napatGNK/DC-power-monitor/README.md

# IoT DC Power Meter

เครื่องวัดพลังงานไฟฟ้ากระแสตรงพร้อมแดชบอร์ดเรียลไทม์ สร้างด้วย ESP32 และเซนเซอร์ INA219

เป้าหมายคือตอบคำถามว่าอุปกรณ์ไฟ DC ที่เราใช้กันกินไฟจริงเท่าไหร่ มัลติมิเตอร์ทั่วไปบอกได้แค่ค่า ณ ขณะนั้น ไม่บอกพลังงานสะสมและมองไม่เห็นการเปลี่ยนแปลงที่เกิดเร็วกว่าจังหวะที่จอจะอัปเดตทัน เครื่องนี้ทำได้ทั้งสองอย่างและดูผ่านมือถือได้

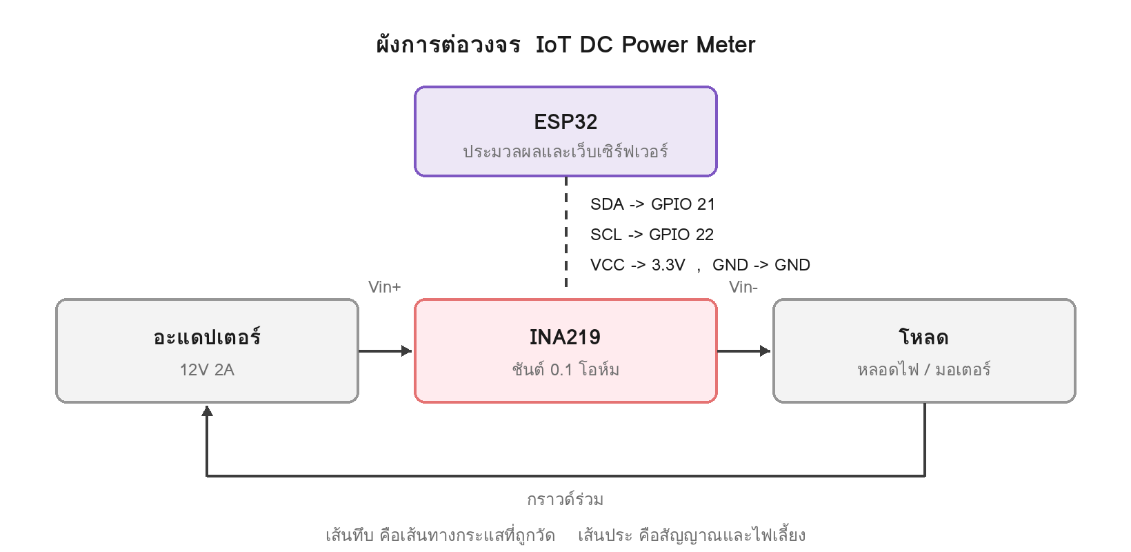
[picture p1: images/wiring_diagram.png]
ผังการต่อวงจร


รายละเอียดการต่อสายทั้งหมดอยู่ใน [wiring.md](wiring.md)

---

## ทำไมต้องสลับย่านการวัดได้

ไลบรารีของ INA219 ตั้งค่าเริ่มต้นไว้ที่ย่าน 32V/2A ซึ่งเป็นค่าที่โปรเจคส่วนใหญ่ใช้ตามกันมาโดยไม่เปลี่ยน

แต่เมื่อวัดโหลดจริงพบว่ามอเตอร์หมุนเปล่ากินราว 120 mA และหลอดไฟราว 220 mA นั่นคือใช้ช่วงการวัดไปเพียงราว 6–11% ของที่เซนเซอร์ทำได้ ความละเอียดที่เหลือจึงหยาบเกินความจำเป็น และสัญญาณรบกวนปรากฏชัดเป็นสัดส่วน

การเปลี่ยนไปใช้ย่าน 16V/400mA ให้ความละเอียดสูงขึ้นราว 5 เท่า แต่แลกมาด้วยเพดานที่ต่ำลง ซึ่งเป็นปัญหาเมื่อต้องวัดกระแสกระชากขณะมอเตอร์เริ่มหมุนที่พุ่งเกิน 600 mA

**จึงออกแบบให้สลับย่านได้สองโหมด** ใช้ย่านละเอียดเมื่อวัดค่าขณะทำงานปกติ และย่านกว้างเมื่อต้องจับค่าสูงสุด สลับได้ทั้งจากปุ่ม BOOT บนบอร์ดและจากหน้าเว็บ

การแลกกันระหว่างความละเอียดกับพิสัยการวัดคือแนวคิดหลักของวิชาการวัด และในโปรเจคนี้มันไม่ได้มาจากตำรา แต่มาจากการวัดโหลดจริงแล้วพบว่าค่าเริ่มต้นไม่เหมาะสม

---

## ข้อสังเกตเรื่องฉลากหลอดไฟ

หลอดที่ใช้ทดสอบระบุบนฉลากว่า 12V 5W

เมื่อวัดจริงที่แรงดัน 12.03 V ซึ่งอยู่ที่ค่าพิกัดพอดี ได้กำลังไฟเพียง 2.691 W

คำนวณย้อนกลับได้ความต้านทานขณะร้อน 12.03 ÷ 0.2237 = 53.8 Ω ขณะที่หลอด 12V 5W ตามทฤษฎีควรมีค่า 12 ÷ 0.417 = 28.8 Ω

ความต้านทานจริงสูงกว่าที่ควรเป็นเกือบสองเท่า เมื่อแรงดันถูกต้องแล้ว ตัวแปรที่เหลือมีเพียงคุณสมบัติของไส้หลอดเอง จึงสรุปได้ว่า **คุณสมบัติจริงของหลอดไม่ตรงกับที่ระบุบนฉลาก**

จึงใช้ค่าที่วัดได้เป็นหลักในการคำนวณทั้งหมด ไม่ใช้ค่าบนฉลาก

---

## อุปกรณ์หลัก

| ส่วน | อุปกรณ์ |
|---|---|
| ประมวลผลและเว็บเซิร์ฟเวอร์ | ESP32 DevKit พร้อมบอร์ดขยาย 30 ขา |
| วัดกระแสและแรงดัน | INA219 ชันต์ 0.1 Ω, I2C address 0x40 |
| แหล่งจ่ายทดสอบ | อะแดปเตอร์ 12V 2A แบบขั้วบวกตรงกลาง |
| โหลดทดสอบ | หลอดไฟ 12V และมอเตอร์เกียร์ ZGA37RG 12V 300 rpm |
| เครื่องมืออ้างอิง | มัลติมิเตอร์ ZENTOR ZT34000 |

---

## การต่อสาย

ฝั่งสัญญาณ

| ขา INA219 | ต่อเข้า ESP32 |
|---|---|
| VCC | 3.3V |
| GND | GND |
| SDA | GPIO 21 |
| SCL | GPIO 22 |

ฝั่งไฟที่ถูกวัด

- ขั้วบวกอะแดปเตอร์ เข้า `Vin+`
- `Vin-` ออกไปยังขั้วบวกของโหลด
- ขั้วลบของโหลด กลับเข้าขั้วลบอะแดปเตอร์

เซนเซอร์ต่อ**อนุกรม**ในเส้นทางไฟ ไม่ใช่ต่อคร่อมแบบโวลต์มิเตอร์

**กราวด์ของ ESP32 ต้องต่อร่วมกับขั้วลบของแหล่งจ่าย** เพราะแรงดันคือผลต่างระหว่างสองจุดเสมอ หากไม่มีจุดอ้างอิงร่วมกัน ค่าที่อ่านได้จะลอยและไม่ซ้ำเดิม

---

## หลักการทำงาน

INA219 มีตัวต้านทานชันต์ 0.1 Ω ต่ออนุกรมอยู่ในเส้นทางไฟ กระแสที่ไหลผ่านทำให้เกิดแรงดันตกคร่อมเล็กน้อย ชิปวัดแรงดันนั้นแล้วใช้กฎของโอห์มคำนวณกลับเป็นกระแส พร้อมกับวัดแรงดันบัสไปด้วย

ESP32 อ่านค่าผ่านบัส I2C ทุก 200 มิลลิวินาที โดยแต่ละรอบอ่าน 20 ครั้งแล้วเฉลี่ยเพื่อลดสัญญาณรบกวน จากนั้นคำนวณ

- กำลังไฟ จากผลคูณของแรงดันกับกระแส
- พลังงานสะสม จากผลรวมของกำลังไฟคูณกับช่วงเวลาที่ผ่านไปในแต่ละรอบ

ค่าพลังงานสะสมนี้เองที่ทำให้อุปกรณ์เป็นมิเตอร์ ไม่ใช่เพียงเครื่องวัดค่าปัจจุบัน

ESP32 เปิดเว็บเซิร์ฟเวอร์ในตัวและส่งค่าออกมาเป็น JSON ให้เบราว์เซอร์ดึงไปวาดกราฟทุกครึ่งวินาที

---

## การออกแบบเพื่อความน่าเชื่อถือ

**โหมดปล่อยสัญญาณไวไฟของตัวเอง** หากเชื่อมต่อเครือข่ายที่ตั้งไว้ไม่สำเร็จภายใน 12 วินาที ระบบจะเปลี่ยนไปปล่อยสัญญาณชื่อ `PowerMeter` เอง ทำให้สาธิตได้ในสถานที่ที่ไม่มีเครือข่ายที่รู้จัก

**แยกแหล่งจ่ายไฟของ ESP32 ออกจากวงจรที่วัด** จ่ายไฟตัวควบคุมผ่าน USB เพื่อไม่ให้กระแสที่ ESP32 ใช้ถูกนับรวมเข้าไปในค่าที่วัด และเพื่อไม่ให้แรงดันตกจากโหลดไปกระทบการทำงาน

**โหมดค่าจำลอง** สลับได้จากค่าคงที่บรรทัดเดียวในโค้ด ใช้พัฒนาและทดสอบหน้าเว็บโดยไม่ต้องต่อฮาร์ดแวร์

**เก็บค่ากระแสสูงสุดไว้ต่างหาก** เพราะปรากฏการณ์ชั่วขณะอย่างกระแสกระชากจะหายไปจากกราฟเมื่อเลื่อนพ้นหน้าจอ

---

## ผลการทดสอบ

### แรงดัน

| ครั้ง | มัลติมิเตอร์ (V) | เครื่องนี้ (V) | คลาดเคลื่อน |
|---|---|---|---|
| 1 | 11.91 | 11.99 | +0.67% |
| 2 | 11.89 | 11.95 | +0.50% |
| 3 | 11.97 | 12.04 | +0.58% |

เฉลี่ย **+0.58%** และเป็นบวกทุกครั้งในช่วงแคบ ซึ่งเป็นลักษณะของความคลาดเคลื่อนเชิงระบบ ไม่ใช่ค่าสุ่ม สาเหตุน่าจะมาจากค่าชันต์จริงไม่ตรง 0.1 Ω พอดี

เนื่องจากมัลติมิเตอร์เองมีความไม่แน่นอนราว ±0.5% จึงสรุปได้เพียงว่าเครื่องมือทั้งสองให้ค่าที่สอดคล้องกัน ไม่สามารถสรุปว่าตัวใดถูกต้องกว่ากัน

### พลังงานสะสม

ทดสอบกับหลอดไฟต่อเนื่อง 126 นาที

| รายการ | ค่า |
|---|---|
| กำลังไฟเฉลี่ย | 2.691 W |
| ระยะเวลา | 2.10 ชั่วโมง |
| คำนวณด้วยมือ | 5.651 Wh |
| เครื่องนับได้ | 5.6001 Wh |
| คลาดเคลื่อน | −0.90% |

ค่าที่ต่ำกว่าเล็กน้อยอธิบายได้ เพราะการคำนวณด้วยมือใช้กำลังไฟ ณ ขณะสุดท้ายมาคูณตลอดช่วง โดยสมมติว่าคงที่ ในความเป็นจริงช่วงแรกที่ไส้หลอดยังไม่ร้อนเต็มที่ กำลังไฟต่ำกว่านั้น ค่าที่เครื่องนับได้จึงน่าเชื่อถือกว่าค่าอ้างอิง

### กระแสกระชากของมอเตอร์

| สภาวะ | กระแส |
|---|---|
| หมุนปกติ | 101–120 mA |
| ขณะสตาร์ท | 285.9 ถึง 616.0 mA |

คิดเป็น 2.4 ถึง 5.1 เท่า เกิดจากในจังหวะแรกมอเตอร์ยังไม่มีแรงเคลื่อนไฟฟ้าต้านกลับ ขดลวดจึงเหลือเพียงความต้านทานล้วน เมื่อความเร็วเพิ่มขึ้น แรงเคลื่อนต้านกลับเพิ่มตาม กระแสจึงลดลงจนเข้าที่

การทดสอบเปิดปิดหลอดไฟซ้ำหลายรอบให้ค่าที่ระดับคงที่เท่ากันทุกครั้ง แสดงว่าการวัดมีความสามารถทำซ้ำได้

---

## ปัญหาที่พบระหว่างสร้าง

**ค่าที่อ่านได้ไม่นิ่ง** — การอ่านค่าเพียงครั้งเดียวต่อรอบทำให้ตัวเลขกระโดดจนอ่านไม่ได้ แก้ด้วยการอ่าน 20 ครั้งแล้วเฉลี่ยก่อนแสดงผล

**ย่านการวัดเริ่มต้นไม่เหมาะกับโหลด** — นำไปสู่การออกแบบระบบสลับย่านตามที่อธิบายไว้ข้างต้น

**โมดูล OLED เสียหาย** — โมดูล OLED เรียงขาเป็น GND/VCC ซึ่งสลับกับ INA219 ที่เป็น VCC/GND ทำให้ต่อไฟกลับขั้วและชิปไดรเวอร์เสียหายถาวร จึงเปลี่ยนไปแสดงผลผ่านเว็บเพียงทางเดียว ซึ่งกลับมีข้อดีคือดูค่าได้จากมือถือโดยไม่ต้องเข้าใกล้วงจรที่มีไฟ

**การเทียบค่าครั้งแรกใช้ย่านมัลติมิเตอร์ผิด** — วัดกระแสในย่าน 10A ซึ่งมีความละเอียดขั้นละ 10 mA ขณะที่ค่าที่วัดอยู่ราว 100 mA ทำให้เปรียบเทียบไม่ได้ ต้องย้ายไปย่าน 200 mA ซึ่งเป็นปัญหาเดียวกับที่เจอในฝั่งเซนเซอร์เอง

---

## ข้อจำกัด

ระบบสุ่มตัวอย่างที่ 5 ครั้งต่อวินาที ขณะที่กระแสกระชากขณะสตาร์ทกินเวลาไม่ถึง 50 มิลลิวินาที ค่าสูงสุดที่บันทึกได้จึงเป็นค่าต่ำสุดที่ยืนยันได้ว่าเกิดขึ้นจริง ไม่ใช่ค่าพีคที่แท้จริง ซึ่งอธิบายว่าทำไมค่าที่วัดได้ในแต่ละครั้งจึงต่างกันมาก

การเฉลี่ย 20 ครั้งต่อรอบยังทำหน้าที่เหมือนตัวกรองความถี่ต่ำ ที่รีดยอดแหลมให้เตี้ยลงโดยธรรมชาติ

หากต้องการวัดกระแสกระชากอย่างแม่นยำ จะต้องเพิ่มอัตราการสุ่ม ลดการเฉลี่ย หรือใช้วงจรจับค่าสูงสุดแบบฮาร์ดแวร์แยกต่างหาก

---

## แนวทางพัฒนาต่อ

- ใช้ INA219 สองตัววัดขาเข้าและขาออกของตัวแปลงไฟ เพื่อคำนวณประสิทธิภาพ
- บันทึกข้อมูลลงการ์ด SD เพื่อดูย้อนหลังระยะยาว
- เพิ่มการแจ้งเตือนเมื่อกระแสเกินค่าที่กำหนด
- ปรับให้ใช้เป็นส่วนแสดงผลของโปรเจค Mini Solar MPPT Charge Controller

---

## การติดตั้ง

ไลบรารีที่ต้องมี Adafruit INA219

1. เปิด `iot_power_meter.ino` ใน Arduino IDE
2. แก้ `WIFI_SSID` และ `WIFI_PASS` ให้เป็นเครือข่ายของคุณ ต้องเป็น 2.4 GHz
3. อัปโหลด แล้วเปิด Serial Monitor ที่ 115200
4. ระบบจะสแกนบัส I2C และแสดง IP address ที่ต้องเปิด

ถ้าต่อเครือข่ายไม่ได้ ระบบจะปล่อยสัญญาณชื่อ `PowerMeter` รหัส `12345678` แล้วเข้าที่ `http://192.168.4.1`

---

## หมายเหตุเรื่องการพัฒนา

โปรเจคนี้ใช้ AI ช่วยร่างโครงสร้างโค้ดและช่วยแก้ปัญหาระหว่างทาง ส่วนการออกแบบระบบ การต่อวงจร การทดสอบ การคาลิเบรตเทียบเครื่องมือมาตรฐาน และการวิเคราะห์ผลทั้งหมด ผู้จัดทำเป็นผู้ดำเนินการเอง

ข้อมูลการวัดทุกตัวเลขในเอกสารนี้มาจากการทดลองจริง
