napatGNK/DC-power-monitor/images/pin_table.png

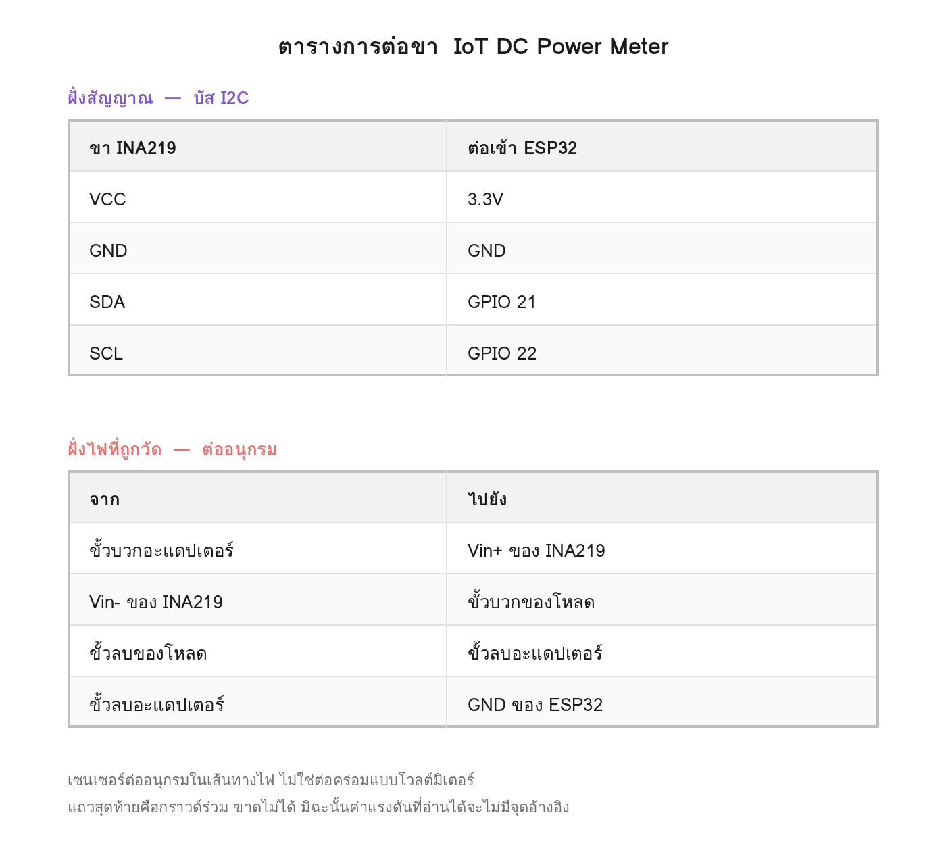
images/pin_table.png
